nullaroni/flatwell/fab/macbook/bambu/flatwell-bambu-tray-left.stl

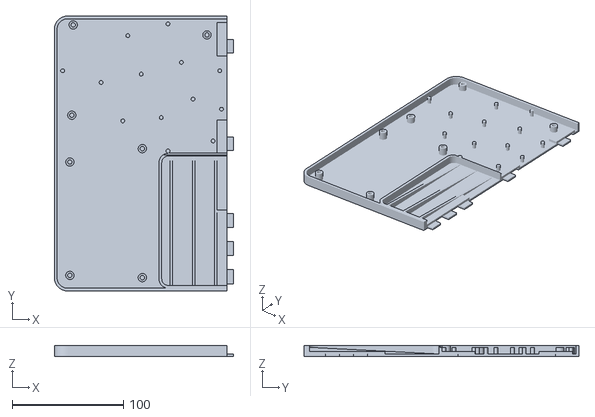
[picture p1: CAD file, 2026-11-11]
fab/macbook/bambu/flatwell-bambu-tray-left.stl
161.0 x 246.7 x 9.60
