nullaroni/flatwell/fab/macbook/flatwell-case-tray.stl

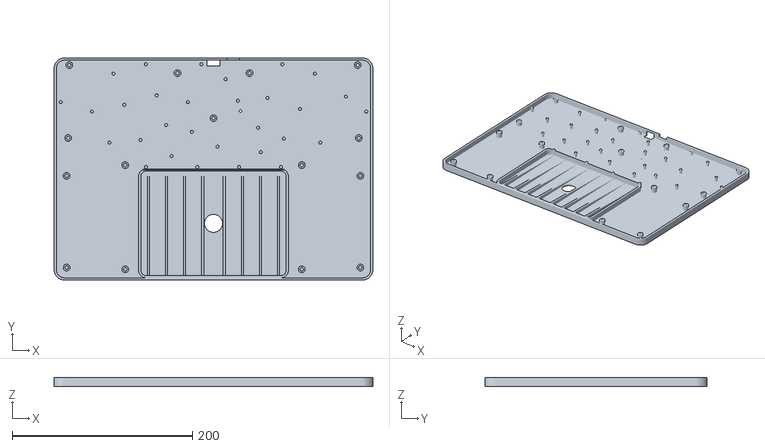
[picture p2: CAD file, 2026-11-11]
fab/macbook/flatwell-case-tray.stl
354.0 x 246.7 x 9.60
