nullaroni/flatwell/fab/macbook/bambu/flatwell-bambu-top-left.stl

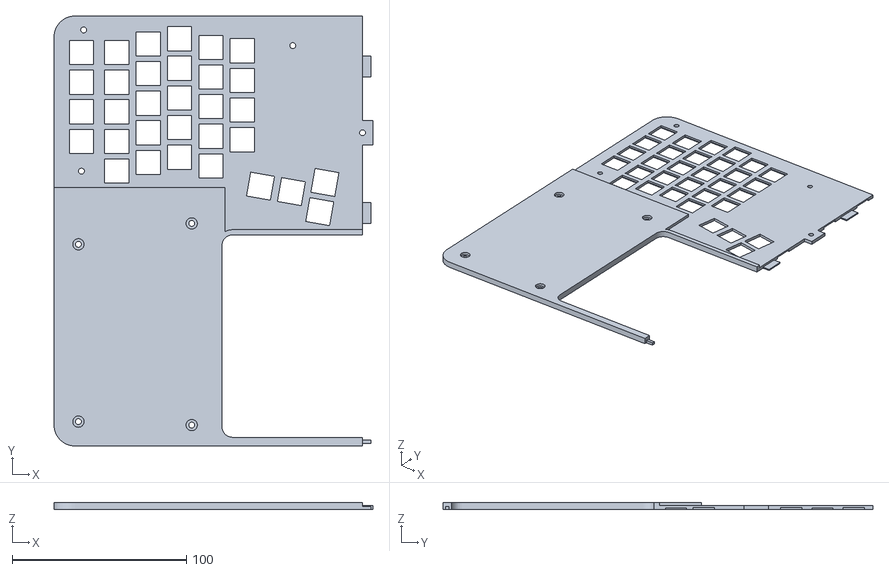
[picture p3: CAD file, 2026-11-11]
fab/macbook/bambu/flatwell-bambu-top-left.stl
183.0 x 246.7 x 4.00
