nullaroni/flatwell/fab/macbook/flatwell-case-top.stl

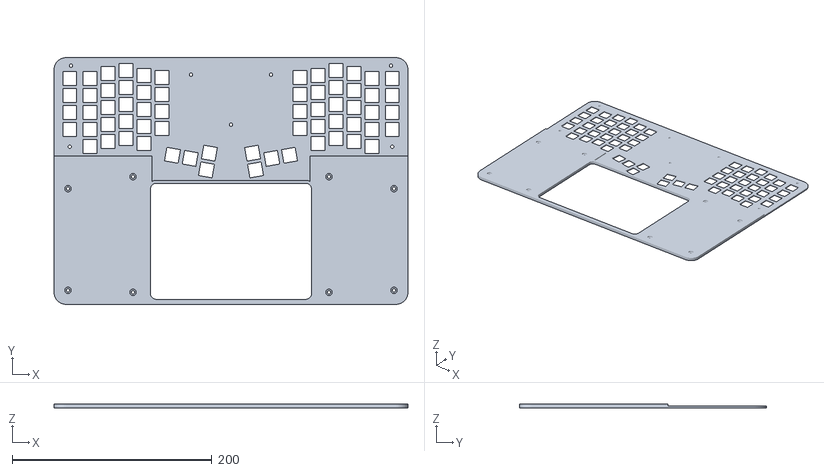
[picture p4: CAD file, 2026-11-11]
fab/macbook/flatwell-case-top.stl
354.0 x 246.7 x 4.00
