nullaroni/flatwell/fab/macbook/bambu/flatwell-bambu-tray-right.stl

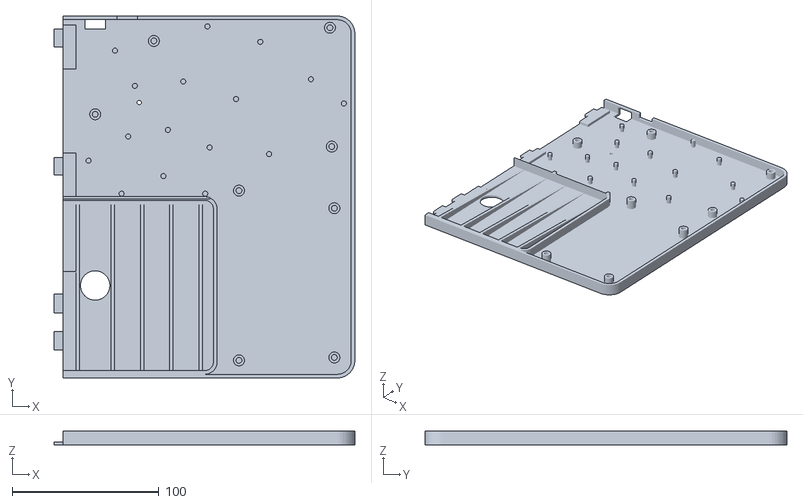
[picture p5: CAD file, 2026-11-11]
fab/macbook/bambu/flatwell-bambu-tray-right.stl
205.0 x 246.7 x 9.60
