nullaroni/flatwell/fab/macbook/bambu/flatwell-bambu-top-right.stl

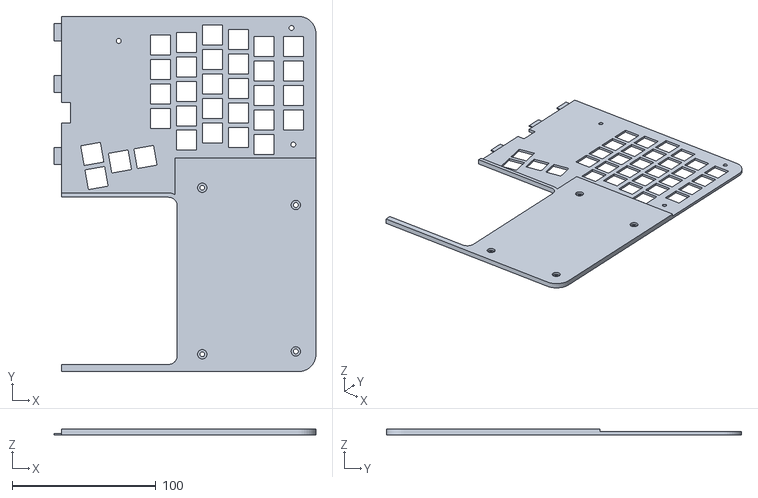
[picture p6: CAD file, 2026-11-11]
fab/macbook/bambu/flatwell-bambu-top-right.stl
182.0 x 246.7 x 4.00
