nullaroni/flatwell/fab/macbook/flatwell.kicad_pcb

## KiCad design fab/macbook/flatwell.kicad_pcb (2026-11-10)

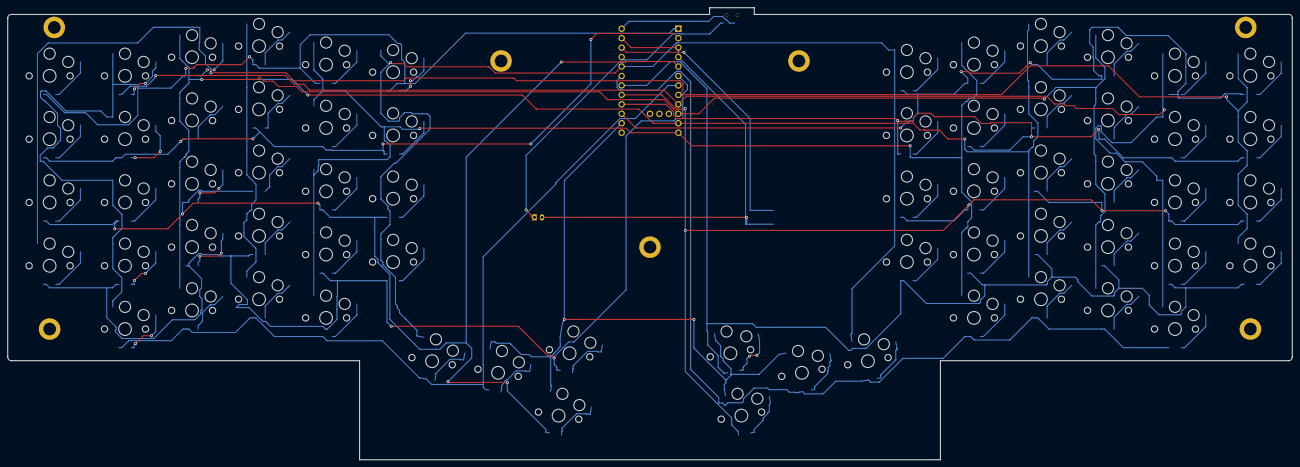
[picture p7: board flatwell.kicad_pcb from above]

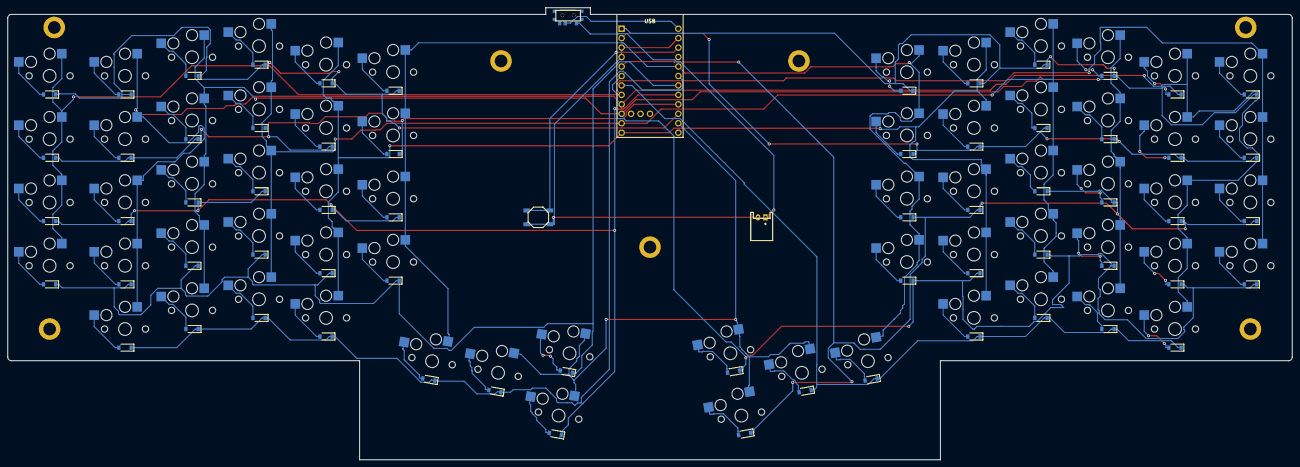
[picture p8: board flatwell.kicad_pcb from below]

Board: 2 copper layers, 345.0 x 121.4 mm, 139 parts (65 on the bottom side), 85 nets.

Parts:
B1: SW_TACT_ALPS_SKQGABE010
D1, D2, D3, D4, D5, D6, D7, D8, D9, D10, D11, D12, D13, D14, D15, D16, D17, D18, D19, D20, D21, D22, D23, D24, D25, D26, D27, D28, D29, D30, D31, D32, D33, D34, D35, D36, D37, D38, D39, D40, D41, D42, D43, D44, D45, D46, D47, D48, D49, D50, D51, D52, D53, D54, D55, D56, D57, D58, D59, D60, D61, D62, D63, D64: 1N4148W; D_SOD-123
H1, H2, H3, H4, H5, H6, H7: M3; MountingHole_M3
JST1: JST_PH_S2B-PH-K_02x2.00mm_Angled
MCU1: nice!nano; nice_nano
S1, S2, S3, S4, S5, S6, S7, S8, S9, S10, S11, S12, S13, S14, S15, S16, S17, S18, S19, S20, S21, S22, S23, S24, S25, S26, S27, S28, S29, S30, S31, S32, S33, S34, S35, S36, S37, S38, S39, S40, S41, S42, S43, S44, S45, S46, S47, S48, S49, S50, S51, S52, S53, S54, S55, S56, S57, S58, S59, S60, S61, S62, S63, S64: PG1350
T1: SPDT_C128955

Connections:
BAT: MCU1.24, T1.2
BAT_IN: JST1.1, T1.1
C0: MCU1.8, S1.1, S2.1, S3.1, S4.1, S33.1, S34.1, S35.1, S36.1
C1: MCU1.9, S5.1, S6.1, S7.1, S8.1, S9.1, S37.1, S38.1, S39.1, S40.1, S41.1
C2: MCU1.10, S10.1, S11.1, S12.1, S13.1, S14.1, S42.1, S43.1, S44.1, S45.1, S46.1
C3: MCU1.11, S15.1, S16.1, S17.1, S18.1, S19.1, S47.1, S48.1, S49.1, S50.1, S51.1
C4: MCU1.12, S20.1, S21.1, S22.1, S23.1, S24.1, S52.1, S53.1, S54.1, S55.1, S56.1
C5: MCU1.20, S25.1, S26.1, S27.1, S28.1, S29.1, S57.1, S58.1, S59.1, S60.1, S61.1
C6: MCU1.14, S30.1, S31.1, S32.1, S62.1, S63.1, S64.1
GND: B1.2, JST1.2, MCU1.3, MCU1.4, MCU1.23
R0: D4.1, D9.1, D14.1, D19.1, D24.1, D28.1, MCU1.1
R1: D3.1, D8.1, D13.1, D18.1, D23.1, D27.1, MCU1.2
R2: D2.1, D7.1, D12.1, D17.1, D22.1, D26.1, D31.1, MCU1.5
R3: D1.1, D6.1, D11.1, D16.1, D21.1, D25.1, D32.1, MCU1.6
R4: D5.1, D10.1, D15.1, D20.1, D29.1, D30.1, MCU1.7
R5: D36.1, D41.1, D46.1, D51.1, D56.1, D60.1, MCU1.15
R6: D35.1, D40.1, D45.1, D50.1, D55.1, D59.1, MCU1.16
R7: D34.1, D39.1, D44.1, D49.1, D54.1, D58.1, D63.1, MCU1.17
R8: D33.1, D38.1, D43.1, D48.1, D53.1, D57.1, D64.1, MCU1.18
R9: D37.1, D42.1, D47.1, D52.1, D61.1, D62.1, MCU1.19
RST: B1.1, MCU1.22
matrix_index_bottom: D20.2, S20.2
matrix_index_home: D22.2, S22.2
matrix_index_num: D24.2, S24.2
matrix_index_top: D23.2, S23.2
matrix_index_zrow: D21.2, S21.2
matrix_inner_home: D26.2, S26.2
matrix_inner_num: D28.2, S28.2
matrix_inner_top: D27.2, S27.2
matrix_inner_zrow: D25.2, S25.2
matrix_middle_bottom: D15.2, S15.2
matrix_middle_home: D17.2, S17.2
matrix_middle_num: D19.2, S19.2
matrix_middle_top: D18.2, S18.2
matrix_middle_zrow: D16.2, S16.2
matrix_outer_home: D2.2, S2.2
matrix_outer_num: D4.2, S4.2
matrix_outer_top: D3.2, S3.2
matrix_outer_zrow: D1.2, S1.2
matrix_pinky_bottom: D5.2, S5.2
matrix_pinky_home: D7.2, S7.2
matrix_pinky_num: D9.2, S9.2
matrix_pinky_top: D8.2, S8.2
matrix_pinky_zrow: D6.2, S6.2
matrix_ring_bottom: D10.2, S10.2
matrix_ring_home: D12.2, S12.2
matrix_ring_num: D14.2, S14.2
matrix_ring_top: D13.2, S13.2
matrix_ring_zrow: D11.2, S11.2
mirror_matrix_index_bottom: D52.2, S52.2
mirror_matrix_index_home: D54.2, S54.2
mirror_matrix_index_num: D56.2, S56.2
mirror_matrix_index_top: D55.2, S55.2
mirror_matrix_index_zrow: D53.2, S53.2
mirror_matrix_inner_home: D58.2, S58.2
mirror_matrix_inner_num: D60.2, S60.2
mirror_matrix_inner_top: D59.2, S59.2
mirror_matrix_inner_zrow: D57.2, S57.2
mirror_matrix_middle_bottom: D47.2, S47.2
mirror_matrix_middle_home: D49.2, S49.2
mirror_matrix_middle_num: D51.2, S51.2
mirror_matrix_middle_top: D50.2, S50.2
mirror_matrix_middle_zrow: D48.2, S48.2
mirror_matrix_outer_home: D34.2, S34.2
mirror_matrix_outer_num: D36.2, S36.2
mirror_matrix_outer_top: D35.2, S35.2
mirror_matrix_outer_zrow: D33.2, S33.2
mirror_matrix_pinky_bottom: D37.2, S37.2
mirror_matrix_pinky_home: D39.2, S39.2
mirror_matrix_pinky_num: D41.2, S41.2
mirror_matrix_pinky_top: D40.2, S40.2
mirror_matrix_pinky_zrow: D38.2, S38.2
mirror_matrix_ring_bottom: D42.2, S42.2
mirror_matrix_ring_home: D44.2, S44.2
mirror_matrix_ring_num: D46.2, S46.2
mirror_matrix_ring_top: D45.2, S45.2
mirror_matrix_ring_zrow: D43.2, S43.2
mirror_thumb_bspc_low: D61.2, S61.2
mirror_thumb_del_low: D62.2, S62.2
mirror_thumb_nav_high: D64.2, S64.2
mirror_thumb_nav_low: D63.2, S63.2
thumb_bspc_low: D29.2, S29.2
thumb_del_low: D30.2, S30.2
thumb_nav_high: D32.2, S32.2
thumb_nav_low: D31.2, S31.2
