nullaroni/flatwell/fab/macbook/flatwell-print.html

1. This is the back of the board, as you'd see it flipped over. Tape the two pages together at the red line.
2. nice!nano: lay it on the outline near the top center, chips facing you, USB port at the board edge. All 24 edge pins must sit on pads.
3. Switch + socket: the two large holes are for a Choc switch's pins (pushed in from the other side). A Kailh Choc hotswap socket should cover both holes and land on the two square pads.
4. Diode: a SOD-123 diode should span the small pad pair under each switch.

Flatwell PCB, back side, left part. Print at 100% (no "fit to page"), then measure the 50 mm bar.

Flatwell PCB, back side, right part. Print at 100% (no "fit to page"), then measure the 50 mm bar.
