nullaroni/flatwell/(commit log)

2026-11-10 Flatwell: flat wireless Advantage-style keyboard with built-in Magic Trackpad
    Ergogen layout (64 keys, MacBook style, sized to a 16-inch MacBook Pro),
    generated and autorouted key PCB for a nice!nano, ZMK shield and local
    firmware build, 1:1 print sheets, and the design plan.
2026-11-10 Add the case, PCB screw holes, order sheet and fab files
    Two-shell case for MJF printing generated from the layout (scripts/case.py),
    seven M3 mounting holes in the PCB, re-routed board, ORDER.md with PCBWay
    specs and the parts list, and the fab outputs so they can be ordered from
    the repo.
    [flatwell-bom.csv, flatwell-case-top.stl, flatwell-case-tray.stl, flatwell.kicad_pcb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]
2026-11-10 Add a power switch; make the order sheet a step-by-step checklist
    MSK-12C02 slide switch between the battery and the nice!nano on a PCB tab at
    the back edge, with a slot in the tray wall. Board re-routed (DRC clean).
    [flatwell-case-tray.stl, flatwell.kicad_pcb]
2026-11-11 Add a case that prints on a Bambu Lab printer
    npm run case:bambu cuts the case into four pieces that fit a 256 mm
    plate: tray seam at x = -22, top seam at x = 0, with tongue-under-roof
    laps along each seam. No supports. Files and a zip are in
    fab/macbook/bambu/; print settings are in ORDER.md, step 4, option B.
    Also fixes the PCBWay top shell: the old extrusion left stray
    zero-thickness faces between switch holes that line up. Solids are now
    extruded by manifold3d directly, and every STL is read back and checked
    after it is written. Shape and size are unchanged.
    [flatwell-bambu-top-left.stl, flatwell-bambu-top-right.stl, flatwell-bambu-tray-left.stl, flatwell-bambu-tray-right.stl, flatwell-case-top.stl, flatwell-case-tray.stl]
